mokhaledd111/Air-levitation-control-system/Project Overview.pdf

### Air levitation control system

Precision control of a levitating ball using an advanced air flow feedback system

Done by:

Mohamed Khaled | 202400729
Khaled Yasser | 202402584

Mohamed Sharkawy 20230100

Marwan Mohamed 202201652

Under the Supervision of:

Dr. Ahmed S. Abd-Rabou

Zewail City of Science and Technology Spring 2026

Introduction :
Air levitation (aerodynamic levitation) is the process of suspending an object in a stable position without mechanical contact by generating a controlled upward airflow that exactly counteracts gravitational force. In the ball-and-pipe control system , a lightweight ball (typically a ping-pong ) is levitated inside a vertical transparent pipe. A blower at the base produces upward airflow, while the ball’s vertical position is continuously measured by a non-contact distance sensor (infrared or ultrasonic). The system is inherently open-loop unstable and exhibits nonlinear dynamics due to the relationship between airflow velocity, pressure distribution (Bernoulli principle), and ball position. Feedback control adjusts the blower speed via PWM to maintain the ball at any desired height. literature survey :
Air levitation systems are widely used in academic laboratories to demonstrate modern control techniques, including PID control, state-space modeling, and digital control. Beyond the classroom, similar systems find applications in magnetic and pneumatic levitation research, precision manufacturing and handling, and in teaching the behavior of nonlinear and inherently unstable systems. Previous studies have shown that the levitation force acting on the ball is a nonlinear function of airflow velocity, which makes the system inherently nonlinear. Consequently, linearization around an operating point is commonly employed to facilitate controller design.

System Block diagram:

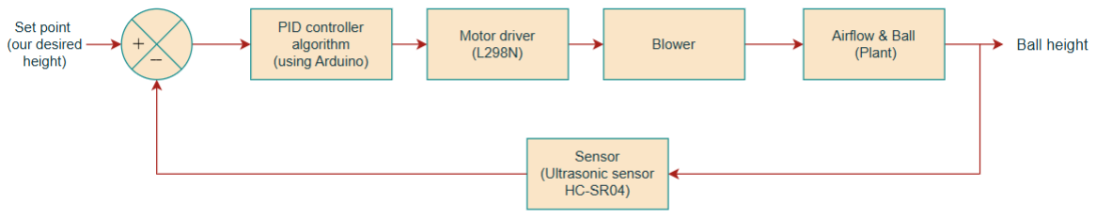
[picture p1: figure]

1. Reference Input
The reference input defines the desired vertical position of the ball inside the pipe. It can be a fixed height for steady-state operation or a varying signal to evaluate the system’s dynamic response and tracking performance.
2. PID Controller
The PID controller, implemented on the Arduino, computes the control signal based on the error between the desired height and the actual ball position. By continuously adjusting the blower speed, it stabilizes the ball at the set point. PID control is preferred for its simplicity and effectiveness in managing nonlinear, unstable systems.
3. Microcontroller (Arduino)
The Arduino acts as the system’s central processing unit. Its main functions include: Reading real-time ball position from the ultrasonic sensor, executing the PID control algorithm and generating PWM signals to control the blower motor
Arduino is chosen for its ease of programming and compatibility with sensors and actuators.
4. Motor Driver (L298N)
The L298N motor driver interfaces between the Arduino and the blower motor. It provides the necessary current to drive the motor while allowing precise speed control via PWM signals from the Arduino.
5. Blower / Fan
The blower converts electrical energy into airflow. The speed of the motor determines the airflow rate, which directly influences the lifting force applied to the ball. Controlled airflow allows precise regulation of the ball height.
6. Airflow & Ball (Plant)
The ball is levitated by the airflow inside the vertical pipe. The lifting force depends nonlinearly on airflow velocity and ball properties. The system dynamics are inherently nonlinear and unstable, making feedback control essential for stable operation.

7. Distance Sensor (Ultrasonic Sensor HC-SR04)
The ultrasonic sensor measures the vertical position of the ball in real time. This feedback signal is sent to the Arduino to close the control loop, enabling accurate and stable height regulation. Schematic
Schematic Diagram:

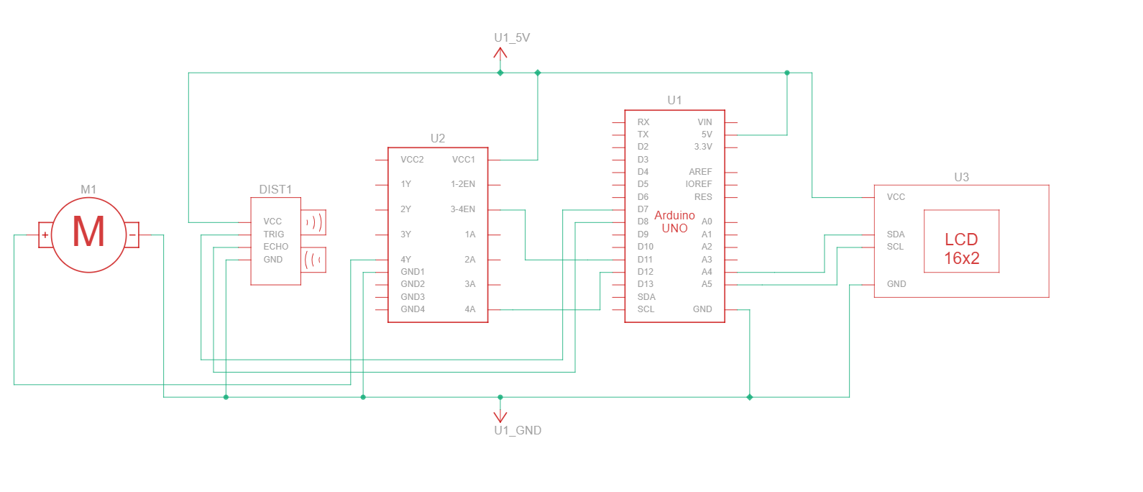
[picture p2: figure]

-The provided schematic serves as the foundational blueprint for the system's hardware layer. It defines the closed-loop control architecture where the Arduino Uno (U1) processes distance data from the ultrasonic sensor (DIST3) to calculate the error relative to a user-defined setpoint. The resulting Pulse Width Modulation (PWM) signal is sent to the L298N driver (U2) to regulate the power delivered to the blower motor (M1), thereby modulating the upward aerodynamic force required for stable levitation.

Pictorial Wiring Diagram:

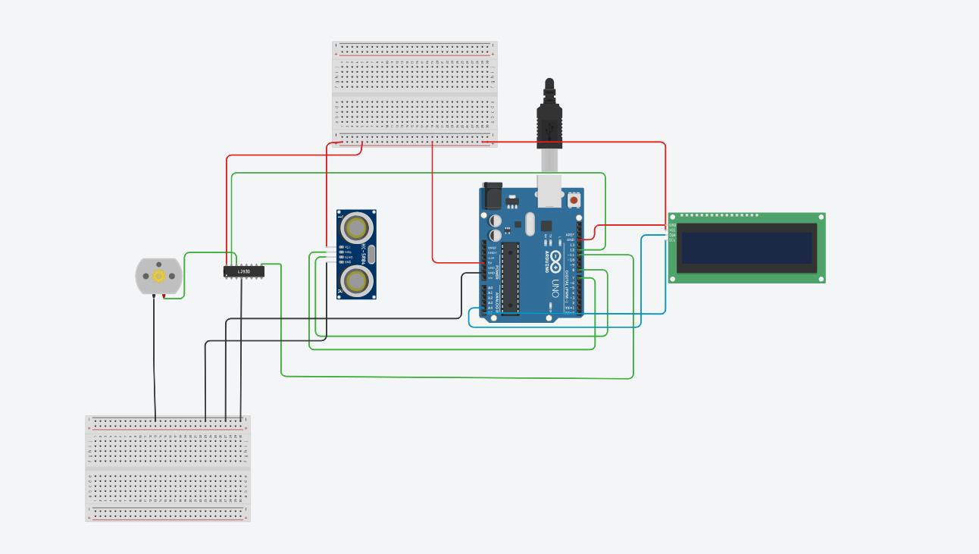
[picture p3: figure]

Controlling process :
Controlling a system is the perennial monitoring of the system which includes revision and correction in order to gain the control objectives and process as planned. In this project the control objective is to impel the ball to track a reference trajectory by regulating the voltage of the blower. The difference between a setpoint and the current position of the ball (position Error) is the input of the controller. The output of the controller will be the control command, sent to the blower driver to control the blower’s rotation speed. Eventually, the position of the ball will be variate according to the generated airflow. Proportional-integral-derivative (PID) controller will be adopted as a model-free linear type control strategy. The PID controller is favorite for its simple functionality which allows for straightforward operation.

## System model :

The system dynamic equations are nonlinear. This is due to the nonlinear description of the air stream, which subjects to the Bernoulli's equation. This equation makes a crucial prediction about the relationship between the pressure and the velocity of a moving ideal fluid:

p1 + 1/2ρv1

2 + ρgy1 = p2 + 1/2ρv2

2 + ρgy2 | (1)

where, 1/2ρv
2

is kinetic energy and ρgy is gravitational potential energy, p1 and p2 are the static pressures of air at the cross-section, ρ is the density of the following air, y1 and y2 are the different distances between the ball and the bottom of the pipe, v1 and v2 are the mean velocities of fluid flow at the cross-section. Once a fluid moves with high velocity, it has lower pressure than the same fluid at low velocity. In the experiments, one side of the Ping-pong ball is in contact with a low pressure which creates a pressure gradient, the other side of the Ping-pong ball is in contact with a higher pressure which results in the Ping-pong ball being pushed towards the region of low pressure. Placing the ball in the tube allows to achieve higher heights but the Bernoulli principle still works. This is because the tube accumulates the air increasing the speed around the ball and allow the ball to go higher. As air is blown out from the blower, it flows at high speed and this creates a region of low pressure across the top of the pipe. The still air around the ball is at a higher pressure and pushes on the ball and causes it to stay floating.
As it is shown in Eq. (2) and Eq. (3), Newton's second law gives us the dynamic equation for the air levitation ball and pipe system, which has been studied by several previous works [13-15]. Forces acting over the levitating object are the buoyancy force ( Fb ), drag force ( Fd ) and weight force of the ball (Fg). Drag force tries to prevent the levitator motion and it is a function of air pressure difference and friction force of air, and Buoyancy is an upward force exerted by a fluid that opposes the weight of a plunged object. Upwards effect of the airflow and the downwards effect of the gravity will induce an up or down motion of the ball (Fig. 3).

m

d

2y
dt

2

= Fb + Fd − Fg | (2)
Fb = ρgVb | (2)
Fd = f(Δp, Ff) | (3)
Fg = mg | (3)
Where Δp is the air pressure difference, ρ is the density of air, g is the gravitational acceleration, m is the mass of the ball, Vb is the ball's volume and Ff is the friction force caused by airflow. The drag coefficient is a term that depends on Reynold's number, which, in turn, depends on the relative velocity of the ball that moves inside the flow, and the velocity of the flow.

Fd(ρ, cd, A, vf, y) = 1/2 ⋅ Cd ⋅ ρ ⋅ A ⋅ (vf − y˙)

2
| (4)
Where, νf is the velocity of the air inside the tube, Ab is the ball's area, Cd is the so-called drag coefficient, and y is the position of the ball in the tube. By summarizing and reforming the relations mentioned above, the system's dynamic equations can be obtained by exploiting net force between the airflow force and gravitational force as:

mΔy¨ = −mg + 1/2 ⋅ Cd ⋅ ρ ⋅ A ⋅ (vf − y˙)

2
+ ρgVb (5)
In this study, it is assumed that cd is constant due to the small velocity of flow. The levitating ball will be in a steady state when it does not move (y¨ = y˙ = 0). The IR sensor measures the distance between the top of the pipe and the ball. In this way, the sensor provides information about the position of the ball. In the following, Veq defined as airspeed at the equilibrium point (veq = vf − y˙). Thus, g defines through:

g =

Cd ⋅ ρ ⋅ A
2(m − ρVb

)

⋅ veq

2
| (6)

Finally, the dynamic equation of the process is expressed as follows:

y¨ = g ⋅ (

m − ρVb
m

) ((
vf − y˙

veq )

2
− 1) | (7)

The system can be modeled either linear or nonlinear. Application of these two states of description depends on the type of control procedures adoption for designing a controller for the setup. Regardless of that, linearization for the system is possible around the equilibrium point by using Taylor's expansion:

f(x) ≈ f(x0

) + f

′
(x0

) ⋅ (x − x0

) | (8)

By assuming x =

νf−y˙

νeq

, and expansion of the relation (7) about the point x = 1, it yields to:

y¨ =

2 ⋅ g

veq

(

m − ρVb
m
) (vf − y˙ − veq) | (9)

Determining the response of a system at an operating point is a critical step in system and controller design. The identification of the process transfer function is carried out in the frequency domain with the open loop tests performed over the system. The system is with one input and one output (SISO). The input signal is wind speed generated by blower and output is an accretion of the position of the ball. Assuming the system is well described by the linearized model, the transfer function between ball position and wind speed is:

y(s)
v(s)

=

1
s
b (s + b) | (10)

Where v(s) and y(s) are wind speed and increment of ball's position about the equilibrium point, respectively and b =
2g(m − ρVb

)/mveq. Considering the fan can be modeled as a first-order process, the transfer function between the input voltage and the wind speed is represented as:

v(s)
u(s)

=

kv τs + 1 | (11)

where v(s), u(s), are wind speed and input voltage, respectively. In addition, kv is the sensitivity gain that relates the input voltage to the wind speed at steady state, and τ is the time constant of the fan. It should be noted that there be existed a delay in the operator, as well as measurement delay, in the ball and pipe system, which needs to be included in the model. The fan used in this setup has electronic components that can bring out a delay in the time of performing the command. Moreover. A lowpass filter has also been used to reduce the signal noise of the measurement, which results in a delay in the system. It is necessary to mention, the values of these delays are not clear and are estimated at the identification phase. In the present paper, the effect of the two delays is assumed to be Td, cumulatively.

e

−Tds =

1 − Tds
Tds + 1

(12)

Finally, the transfer function of the entire system defines as follows:

G(s) =

y(s)
u(s)

=

b ⋅ kv⋅

(1 − Tds)
s(s + b)(τs + 1)(Tds + 1)

(13)

However, this function does not describe the behavior of the system, solely, due to the limited length of the pipe, it is necessary to add a saturation block after the function. The saturation function has a lower bound of 0 and an upper bound of 40 cm . Also, the behavior of the system indicates that the ball does not move with small values of the input, so adding a dead-zone block after the input in the model will make the system performance more precise.

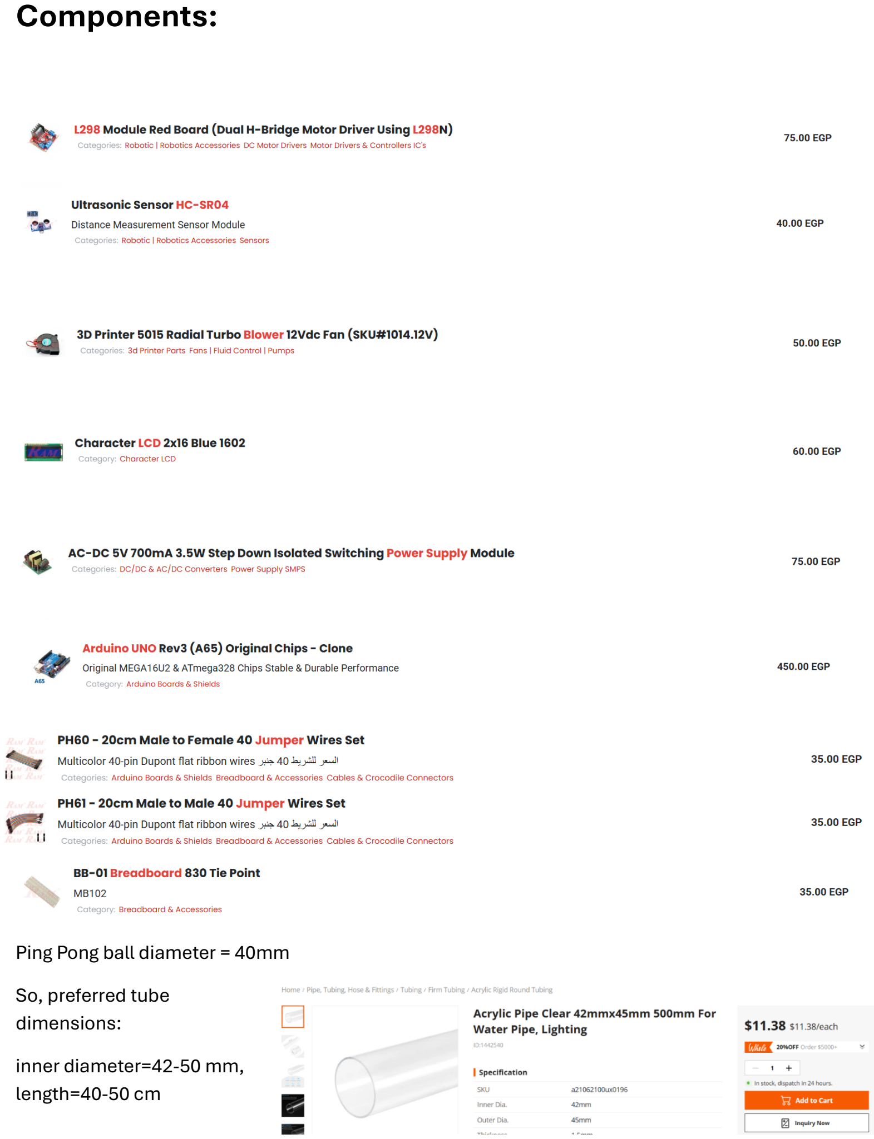
[picture p4: page 12]

Components:

Ping Pong ball diameter = 40mm So, preferred tube
dimensions:

inner diameter=42-50 mm,
length=40-50 cm
