mokhaledd111/Air-levitation-control-system/Documents/System identification using MATLAB with Arduino.pdf

## Air levitation control system

### Stage 2

## Done by:

Mohamed Khaled | 202400729
Khaled Yasser | 202402584

## Mohamed Sharkawy 20230100

Marwan Mohamed | 202201652
Ahmed Mohamed | 202100247

Under the Supervision of:

### Dr. Ahmed S. Abd-Rabou

### Zewail City of Science and Technology Spring 2026

We have successfully completed our setup and performed the mathematical analysis for this stage.
Our completed setup:

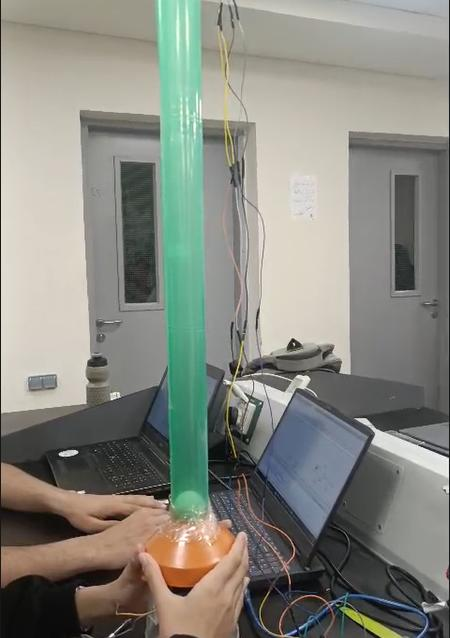
[picture p19: figure]

Also we have made a video for our working system: https://drive.google.com/file/d/11mYf-6kLQ8GkJO9I-CmH1SHdcjRzo1Nq/view?usp=drive_link (https://drive.google.com/file/d/11mYf-6kLQ8GkJO9I-CmH1SHdcjRzo1Nq/view?usp=drive_link)

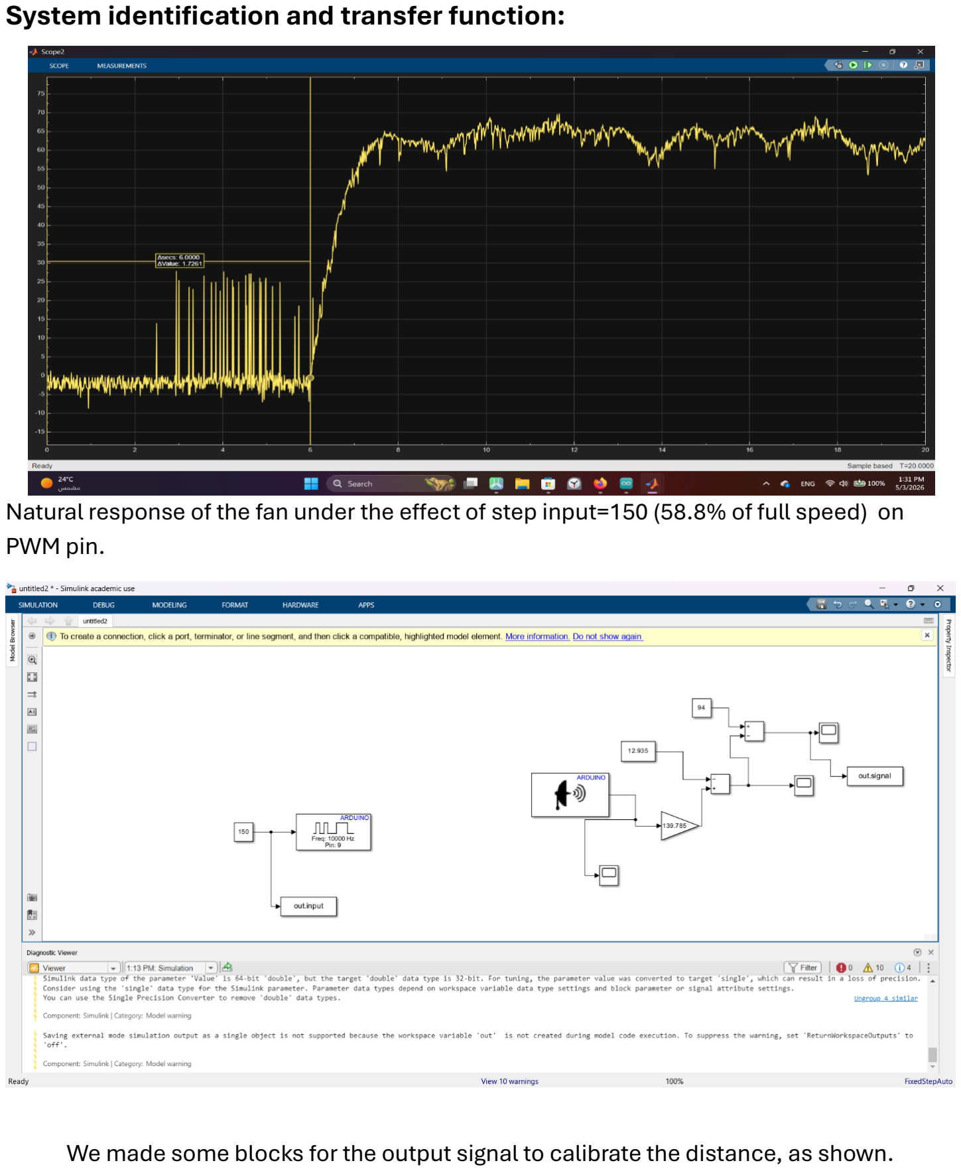
[picture p20: page 3]

System identification and transfer function:

Natural response of the fan under the effect of step input=150 (58.8% of full speed) on PWM pin.

We made some blocks for the output signal to calibrate the distance, as shown.

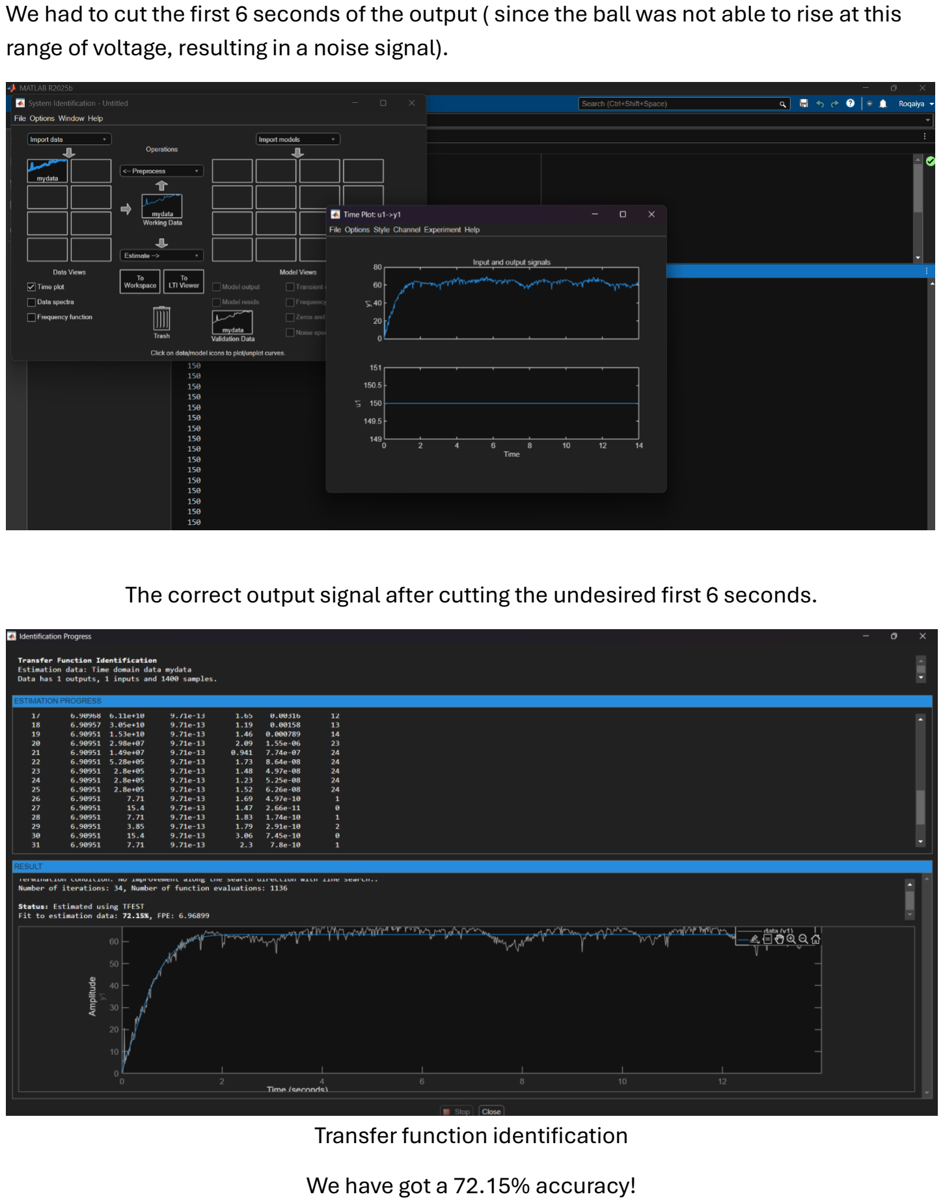
[picture p21: page 4]

We had to cut the first 6 seconds of the output ( since the ball was not able to rise at this range of voltage, resulting in a noise signal).

The correct output signal after cutting the undesired first 6 seconds.

Transfer function identification We have got a 72.15% accuracy!

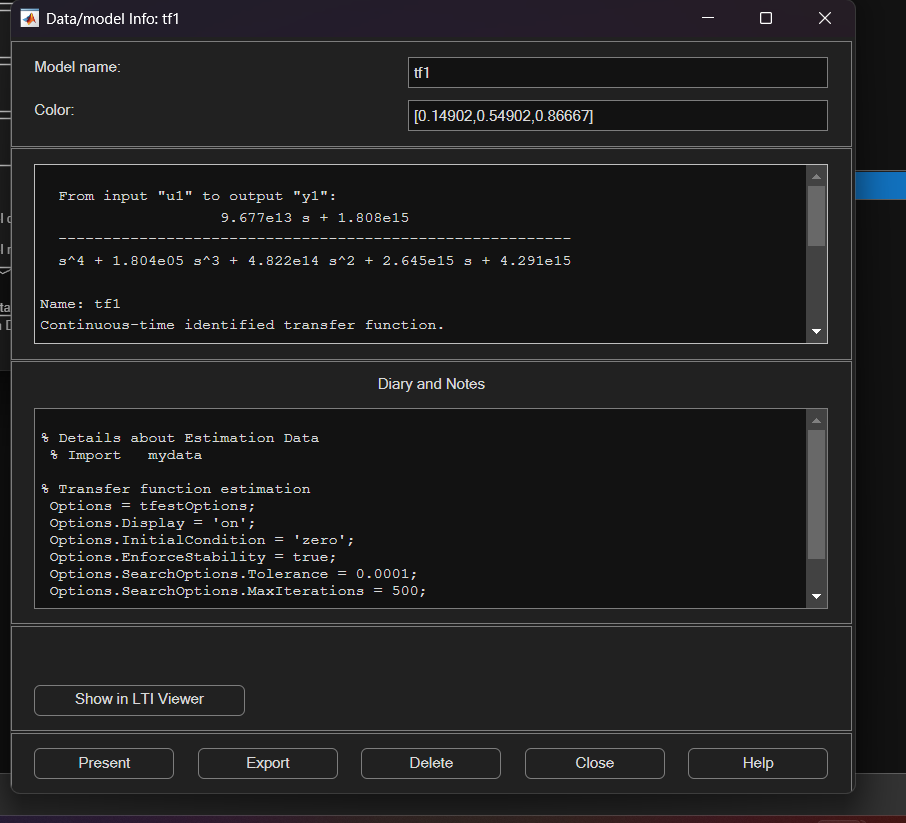
[picture p22: figure]

We guessed the transfer function as the theoretical analysis says, which is in the form of:

G(s) =

y(s)
u(s)

=

b⋅kv⋅

(1−Tds)
s(s+b)(τs+1)(Tds+1)

(4 poles and 1 zero).
